chrisl212/ece49022/PCBs/DriveSystem/DriveSystem.kicad_pcb

## KiCad design PCBs/DriveSystem/DriveSystem.kicad_pcb (2019-10-23)

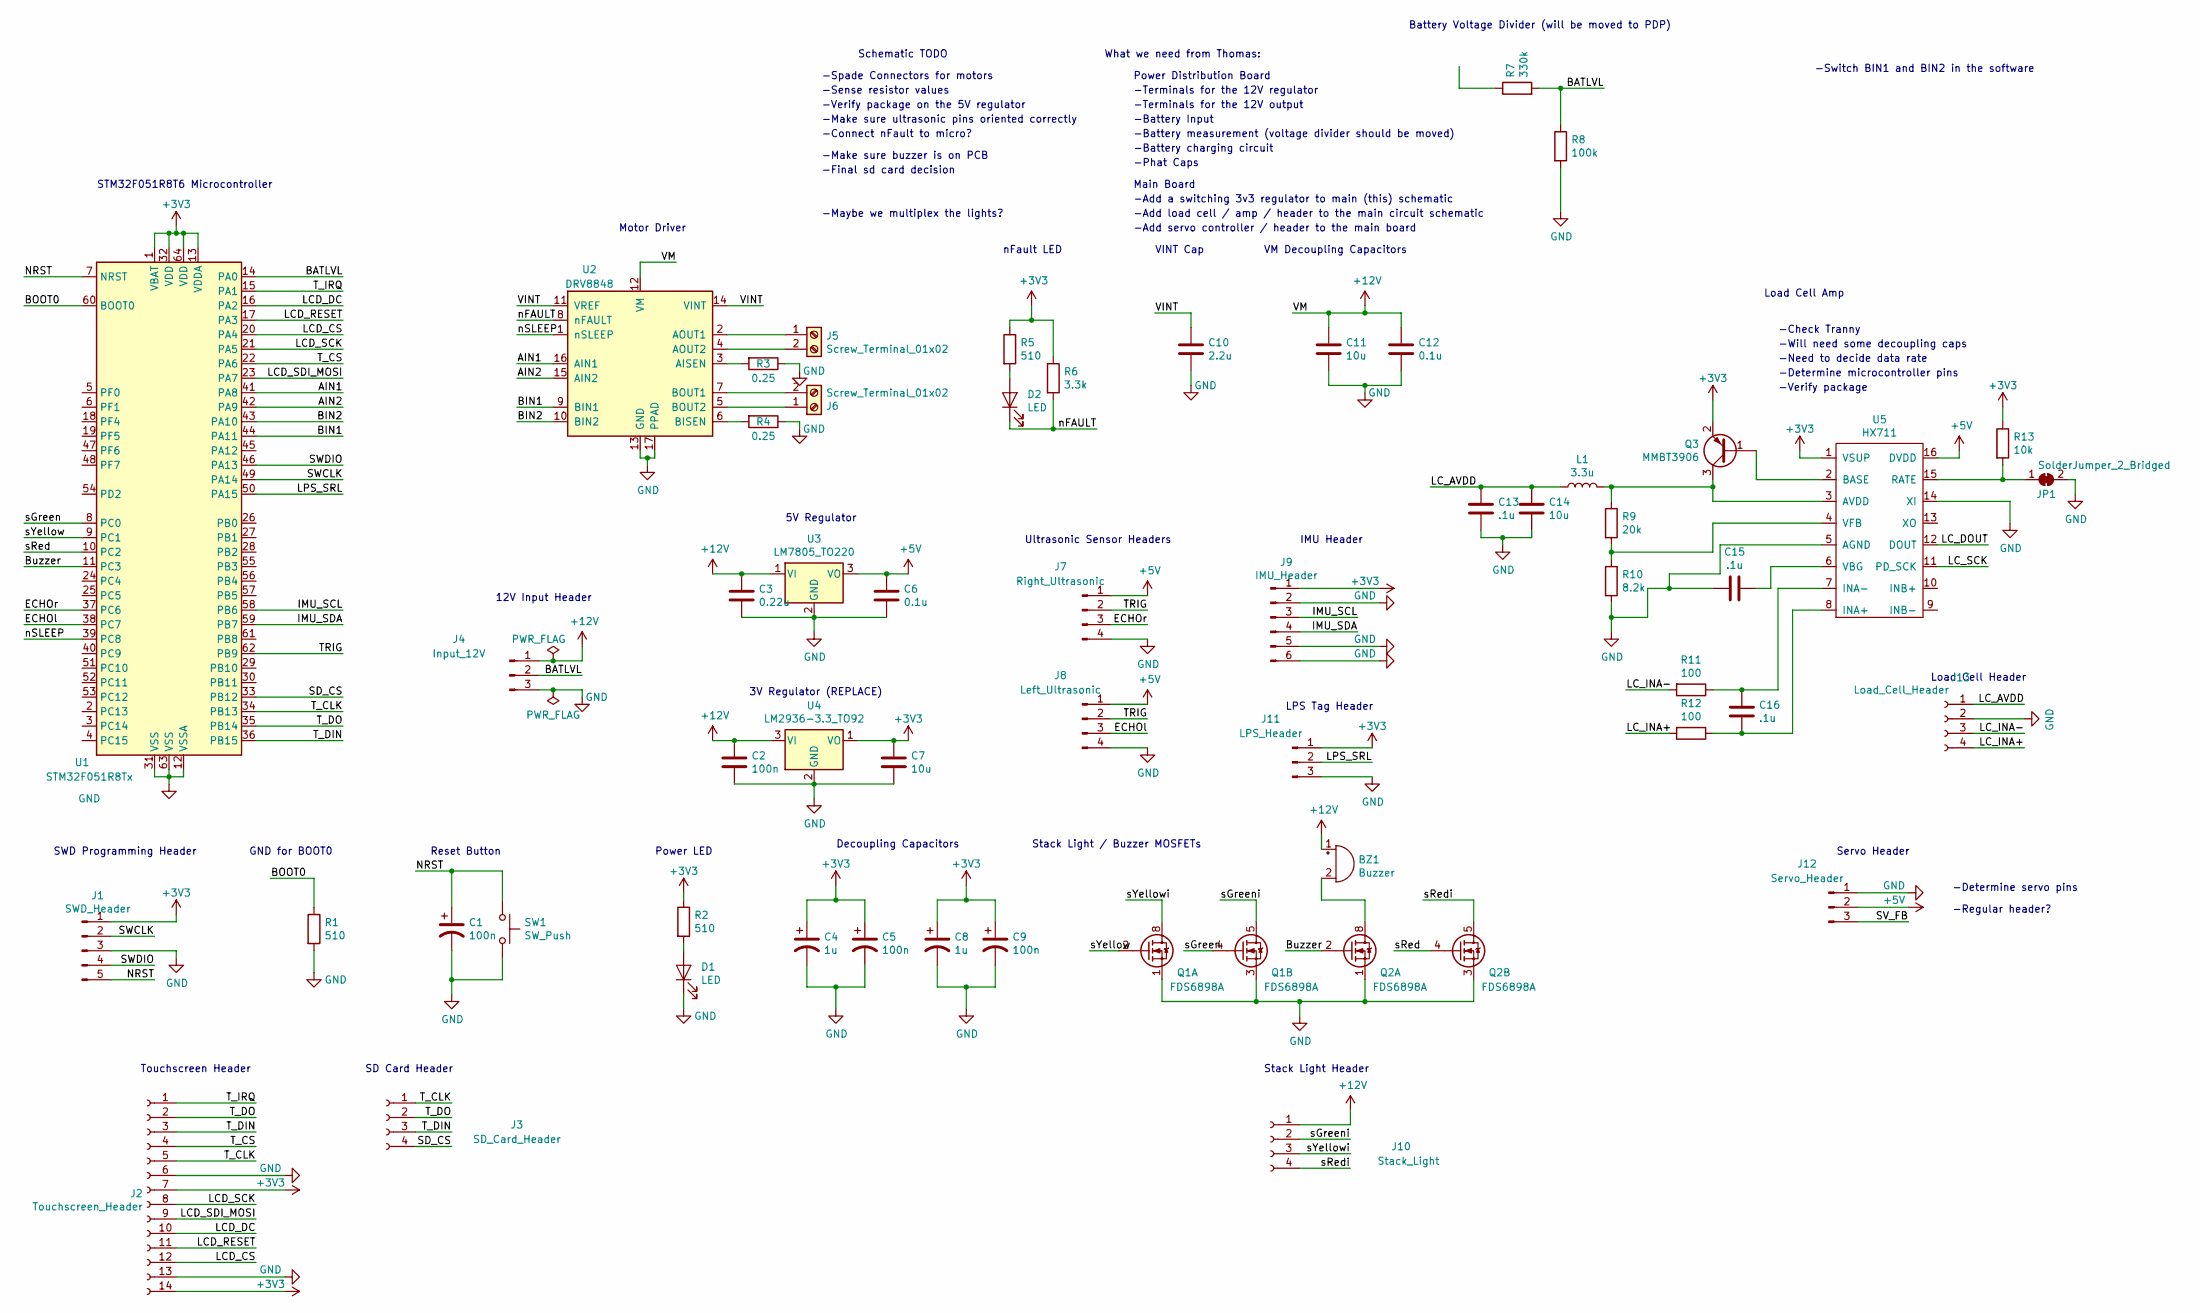
[picture p1: schematic DriveSystem.sch, RoboPicasso Main Board]

Parts:
BZ1: Buzzer; Mallory-PK-27H25PQ-Buzzer
C1, C2, C5, C9: 100n; C_0805_2012Metric_Pad1.15x1.40mm_HandSolder
C3: 0.22u; C_0805_2012Metric_Pad1.15x1.40mm_HandSolder
C4, C8: 1u; C_0805_2012Metric_Pad1.15x1.40mm_HandSolder
C6, C12: 0.1u; C_0805_2012Metric_Pad1.15x1.40mm_HandSolder
C7, C11, C14: 10u; C_0805_2012Metric_Pad1.15x1.40mm_HandSolder
C10: 2.2u; C_0805_2012Metric_Pad1.15x1.40mm_HandSolder
C13, C15, C16: .1u; C_0805_2012Metric_Pad1.15x1.40mm_HandSolder
D1, D2: LED; LED_1206_3216Metric_Pad1.42x1.75mm_HandSolder
J1: SWD_Header; PinHeader_1x05_P2.54mm_Vertical
J2: Touchscreen_Header; PinSocket_1x14_P2.54mm_Vertical
J3: SD_Card_Header; PinSocket_1x04_P2.54mm_Vertical
J4: Input_12V; PinHeader_1x03_P2.54mm_Vertical
J5, J6: Screw_Terminal_01x02; TerminalBlock_4Ucon_1x02_P3.50mm_Horizontal
J7: Right_Ultrasonic; PinHeader_1x04_P2.54mm_Vertical
J8: Left_Ultrasonic; PinHeader_1x04_P2.54mm_Vertical
J9: IMU_Header; PinHeader_1x06_P2.54mm_Vertical
J10: Stack_Light; PinSocket_1x04_P2.54mm_Vertical
J11: LPS_Header; PinHeader_1x03_P2.54mm_Vertical
J12: Servo_Header; PinHeader_1x03_P2.54mm_Vertical
J13: Load_Cell_Header; PinSocket_1x04_P2.54mm_Vertical
JP1: SolderJumper_2_Bridged; SolderJumper-2_P1.3mm_Bridged2Bar_Pad1.0x1.5mm
L1: 3.3u; L_0805_2012Metric_Pad1.15x1.40mm_HandSolder
Q1, Q2: FDS6898A; SOIC-8_3.9x4.9mm_P1.27mm
Q3: MMBT3906; SOT-23
R1, R2, R5: 510; R_0805_2012Metric_Pad1.15x1.40mm_HandSolder
R3, R4: 0.25; R_2512_6332Metric_Pad1.52x3.35mm_HandSolder
R6: 3.3k; R_0805_2012Metric_Pad1.15x1.40mm_HandSolder
R7: 330k; R_0805_2012Metric_Pad1.15x1.40mm_HandSolder
R8: 100k; R_0805_2012Metric_Pad1.15x1.40mm_HandSolder
R9: 20k; R_0805_2012Metric_Pad1.15x1.40mm_HandSolder
R10: 8.2k; R_0805_2012Metric_Pad1.15x1.40mm_HandSolder
R11, R12: 100; R_0805_2012Metric_Pad1.15x1.40mm_HandSolder
R13: 10k; R_0805_2012Metric_Pad1.15x1.40mm_HandSolder
SW1: SW_Push; SW_PUSH_6mm
U1: STM32F051R8Tx; LQFP-64_10x10mm_P0.5mm
U2: DRV8848; TSSOP-16-1EP_4.4x5mm_P0.65mm
U3: LM7805_TO220; TO-220-3_Vertical
U4: LM2936-3.3_TO92; TO-92_Inline
U5: HX711; SOP-16_4.55x10.3mm_P1.27mm

Connections:
+3V3: C4.1, C5.1, C7.1, C8.1, C9.1, J1.1, J2.7, J2.14, J9.1, J11.1, Q3.2 (E), R2.1, R5.1, R6.1, R13.1, U1.1 (VBAT), U1.13 (VDDA), U1.32 (VDD), U1.64 (VDD), U4.1 (VO), U5.1 (VSUP)
+5V: C6.1, J7.1, J8.1, J12.2, U3.3 (VO), U5.16 (DVDD)
+12V: BZ1.1 (-), C2.1, C3.1, C11.1, C12.1, J4.1, J10.1, U2.12 (VM), U3.1 (VI), U4.3 (VI); also elsewhere on the board
/AIN1: U1.41 (PA8), U2.16 (AIN1)
/AIN2: U1.42 (PA9), U2.15 (AIN2)
/BATLVL: J4.2, R7.2, R8.1, U1.14 (PA0)
/BIN1: U1.44 (PA11), U2.9 (BIN1)
/BIN2: U1.43 (PA10), U2.10 (BIN2)
/BOOT0: R1.1, U1.60 (BOOT0)
/Buzz: BZ1.2 (+), Q2.7 (D1), Q2.8 (D1); also elsewhere on the board
/Buzzer: Q2.2 (G1), U1.11 (PC3)
/ECHOl: J8.3, U1.38 (PC7)
/ECHOr: J7.3, U1.37 (PC6)
/IMU_SCL: J9.3, U1.58 (PB6)
/IMU_SDA: J9.4, U1.59 (PB7)
/LCD_CS: J2.12, U1.20 (PA4)
/LCD_DC: J2.10, U1.16 (PA2)
/LCD_RESET: J2.11, U1.17 (PA3)
/LCD_SCK: J2.8, U1.21 (PA5)
/LCD_SDI_MOSI: J2.9, U1.23 (PA7)
/LC_AVDD: C13.2, C14.2, J13.1, L1.1
/LC_DOUT: U5.12 (DOUT)
/LC_INA+: J13.4, R12.2
/LC_INA-: J13.3, R11.2
/LC_SCK: U5.11 (PD_SCK)
/LPS_SRL: J11.2, U1.50 (PA15)
/NRST: C1.1, J1.5, SW1.1, U1.7 (NRST)
/PA12: U1.45 (PA12)
/PB0: U1.26 (PB0); also elsewhere on the board
/PB1: U1.27 (PB1); also elsewhere on the board
/PB2: U1.28 (PB2); also elsewhere on the board
/PB3: U1.55 (PB3)
/PB4: U1.56 (PB4)
/PB5: U1.57 (PB5)
/PB10: U1.29 (PB10); also elsewhere on the board
/PB11: U1.30 (PB11); also elsewhere on the board
/PC4: U1.24 (PC4)
/PC5: U1.25 (PC5)
/PC9: U1.40 (PC9)
/PC10: U1.51 (PC10)
/PC11: U1.52 (PC11)
/PC12: U1.53 (PC12)
/PC13: U1.2 (PC13)
/PC14: U1.3 (PC14)
/PC15: U1.4 (PC15)
/PD2: U1.54 (PD2)
/PF0: U1.5 (PF0)
/PF1: U1.6 (PF1)
/PF4: U1.18 (PF4)
/PF5: U1.19 (PF5)
/PF6: U1.47 (PF6)
/PF7: U1.48 (PF7)
/SD_CS: J3.4, U1.33 (PB12)
/SV_FB: J12.3, U1.61 (PB8)
/SWCLK: J1.2, U1.49 (PA14)
/SWDIO: J1.4, U1.46 (PA13)
/TRIG: J7.2, J8.2, U1.62 (PB9)
/T_CLK: J2.5, J3.1, U1.34 (PB13)
/T_CS: J2.4, U1.22 (PA6)
/T_DIN: J2.3, J3.3, U1.36 (PB15)
/T_DO: J2.2, J3.2, U1.35 (PB14)
/T_IRQ: J2.1, U1.15 (PA1)
/VINT: C10.1, U2.11 (VREF), U2.14 (VINT)
/nFAULT: D2.1 (K), R6.2, U2.8 (nFAULT)
/nSLEEP: U1.39 (PC8), U2.1 (nSLEEP)
/sGreen: Q1.4 (G2), U1.8 (PC0)
/sGreeni: J10.2, Q1.5 (D2), Q1.6 (D2)
/sRed: Q2.4 (G2), U1.10 (PC2)
/sRedi: J10.4, Q2.5 (D2), Q2.6 (D2)
/sYellow: Q1.2 (G1), U1.9 (PC1)
/sYellowi: J10.3, Q1.7 (D1), Q1.8 (D1)
GND: C1.2, C2.2, C3.2, C4.2, C5.2, C6.2, C7.2, C8.2, C9.2, C10.2, C11.2, C12.2, C13.1, C14.1, C15.2, D1.1 (K), J1.3, J2.6, J2.13, J4.3, J7.4, J8.4, J9.2, J9.5, J9.6, J11.3, J12.1, J13.2, JP1.2 (B), Q1.1 (S1), Q1.3 (S2), Q2.1 (S1), Q2.3 (S2), R1.2, R3.1, R4.1, R8.2, R10.2, SW1.2, U1.12 (VSSA), U1.31 (VSS), U1.63 (VSS), U2.13 (GND), U2.17 (PPAD), U3.2 (GND), U4.2 (GND), U5.5 (AGND), U5.14 (XI)
unnamed: C15.1, U5.6 (VBG)
unnamed: C16.1, R12.1, U5.8 (INA+)
unnamed: C16.2, R11.1, U5.7 (INA-)
unnamed: D1.2 (A), R2.2
unnamed: D2.2 (A), R5.2
unnamed: J5.1, U2.2 (AOUT1)
unnamed: J5.2, U2.4 (AOUT2)
unnamed: J6.1, U2.5 (BOUT2)
unnamed: J6.2, U2.7 (BOUT1)
unnamed: JP1.1 (A), R13.2, U5.15 (RATE)
unnamed: L1.2, Q3.3 (C), R9.1, U5.3 (AVDD)
unnamed: Q3.1 (B), U5.2 (BASE)
unnamed: R3.2, U2.3 (AISEN)
unnamed: R4.2, U2.6 (BISEN)
unnamed: R9.2, R10.1, U5.4 (VFB)

Notes on the sheet:
-Spade Connectors for motors
-Sense resistor values
-Verify package on the 5V regulator
-Make sure ultrasonic pins oriented correctly
-Connect nFault to micro?
SWD Programming Header
GND for BOOT0
Reset Button
Power LED
Decoupling Capacitors
5V Regulator
Ultrasonic Sensor Headers
Motor Driver
VINT Cap
nFault LED
VM Decoupling Capacitors
12V Input Header
Schematic TODO
STM32F051R8T6 Microcontroller
Touchscreen Header
SD Card Header
-Make sure buzzer is on PCB
-Final sd card decision
Stack Light / Buzzer MOSFETs
Stack Light Header
What we need from Thomas:
-Terminals for the 12V regulator
-Terminals for the 12V output
-Battery Input
-Battery measurement (voltage divider should be moved)
-Battery charging circuit
-Add load cell / amp / header to the main circuit schematic
-Add a switching 3v3 regulator to main (this) schematic
Power Distribution Board
Main Board
-Add servo controller / header to the main board
-Maybe we multiplex the lights?
Battery Voltage Divider (will be moved to PDP)
-Phat Caps
IMU Header
LPS Tag Header
3V Regulator (REPLACE)
-Check Tranny
-Will need some decoupling caps
-Need to decide data rate
-Determine microcontroller pins
Load Cell Amp
Load Cell Header
Servo Header
-Determine servo pins
-Regular header?
-Verify package
-Switch BIN1 and BIN2 in the software

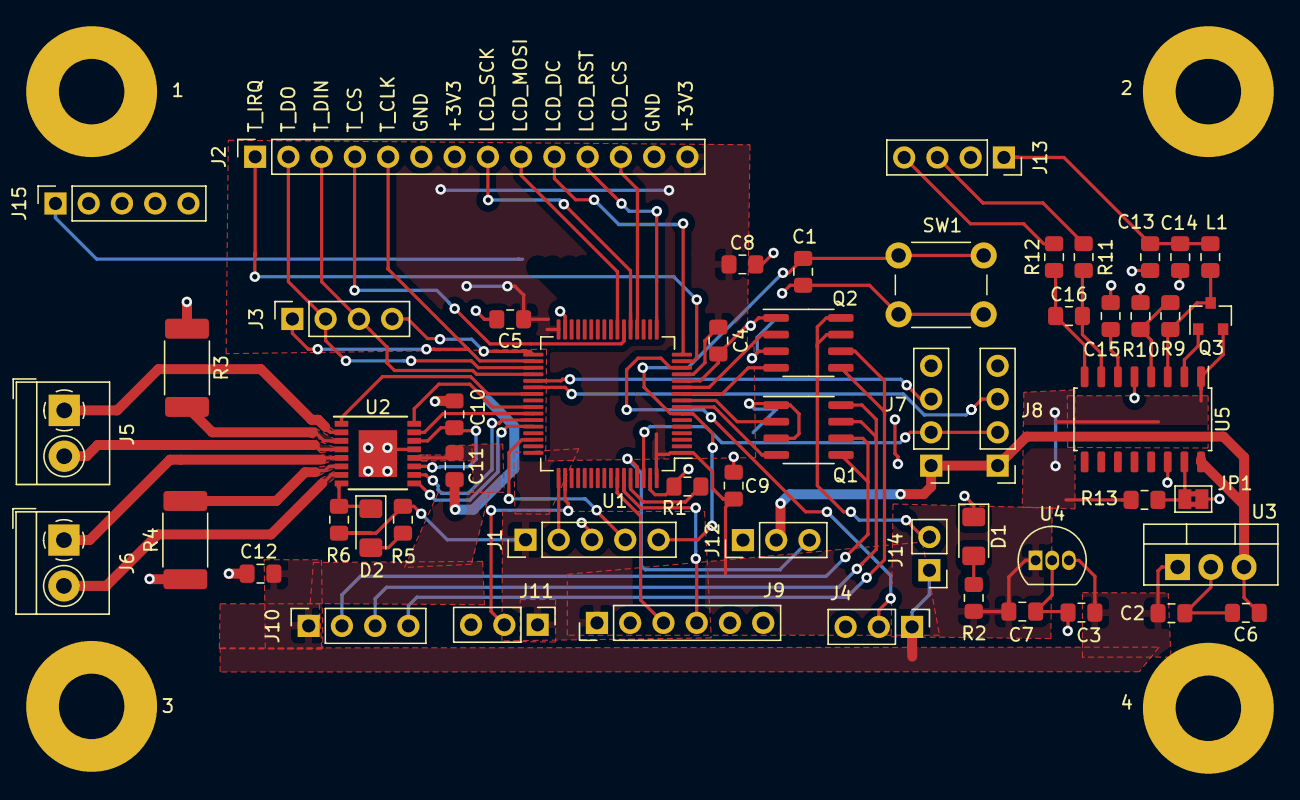
[picture p2: board DriveSystem.kicad_pcb from above]

Board: 2 copper layers, 59 parts (0 on the bottom side), 65 nets.

Other parts of the board:
1, 2, 3, 4: MountingHole_5mm_Pad
J14: Conn_01x02_Male; PinHeader_1x02_P2.54mm_Vertical
J15: Conn_01x05_Female; PinSocket_1x05_P2.54mm_Vertical

Their connections:
+12V: J14.1; also elsewhere on the board
/Buzz: J14.2; also elsewhere on the board
/PB0: J15.5; also elsewhere on the board
/PB1: J15.4; also elsewhere on the board
/PB2: J15.3; also elsewhere on the board
/PB10: J15.2; also elsewhere on the board
/PB11: J15.1; also elsewhere on the board
