chrisl212/ece49022/robo/src/nav/nav.c

#include <stddef.h>
#include "stm32f0xx.h"
#include "ui/text/text.h"
#include "nav.h"
#include "lps/lps.h"
#include "state/state.h"
#include "ui/ui.h"
#include "ui/stack/stack.h"
#include "math/math.h"
#include "drive/drive.h"
#include "sensors/sensors.h"

#define SAMPLES (10)
#define OFFSET (15)
#define TEST (11)

fatFile_t design;
uint16_t initialHead = 0, desiredHead;
int16_t head;
uint16_t desiredX = OFFSET;
uint16_t desiredY = OFFSET;
uint8_t avgCnt;
int lastPoint = 0;

void TIM14_IRQHandler(void) {
    uint8_t p;

    if (load_empty()) {
        state_setErrorMessage("PAINT LOW!!!");
        if (state_get() != STATE_ERR) {
            state_set(STATE_ERR);
            ui_draw();
        }
		GPIOB->ODR |= (1 << TEST);
	    drive_stop();
		drive_move();
		GPIOB->ODR &= ~(1 << TEST);
        return;
    } else if (state_get() == STATE_ERR) {
        state_restore();
        ui_draw();
        drive_start();
    } 
    if (state_get() != STATE_ERR) {
        nav_move(NULL, NULL, &p);
		if (p) {
			servo_on();
		} else {
			servo_off();
		}
        drive_move();
    }
    TIM14->SR &= ~(TIM_SR_UIF);
}

int nav_setup(fatFile_t file) {
    int s;

    design = file;
    lps_setup();

    NVIC_SetPriority(USART2_IRQn, 0);
    NVIC_SetPriority(TIM14_IRQn, 4);
    RCC->APB1ENR |= RCC_APB1ENR_TIM14EN;
    TIM14->PSC = 4800 - 1;
    TIM14->ARR = 10 - 1;
    TIM14->DIER |= TIM_DIER_UIE;
    NVIC->ISER[0] |= 1 << TIM14_IRQn;
    TIM14->CR1 |= TIM_CR1_CEN;

    load_init();
    servo_init();
	while (initialHead == 0)
		lps_getCoords(NULL, NULL, &initialHead);
    return 0;
}

static int _getNextCoords(uint16_t *x, uint16_t *y, uint8_t *p) {
    uint8_t buff[12];
    uint16_t tmpX, tmpY;
    int status;

    status = fat_read(&design, buff, 12);
    tmpX = ((buff[1] << 8) | buff[0]);
    tmpY = 1000 - ((buff[5] << 8) | buff[4]);
    if (p) {
        *p = (buff[9] << 8) | buff[8];
    }
    tmpX /= 10;
    tmpY /= 10;
    *x = tmpX;
    *y = tmpY;
    return status;
}

static int _abs(int x) {
    return (x < 0) ? -x : x;
}

void nav_move(uint16_t *angle, uint8_t *speed, uint8_t *paint) {
    int16_t currentX, currentY;
	uint16_t currentHead;
    uint16_t nextX, nextY;
    int16_t nextHead;
    int status;

    lps_getCoords(&currentX, &currentY, &currentHead);
	head = currentHead - initialHead;
	if (head < 0) {
		head += 360;
	}
    if (_abs(currentX - desiredX) < 20 && _abs(currentY - desiredY) < 20) {
		headPID.integral = 0;
		if (lastPoint) {
			state_set(STATE_DONE);
			ui_draw();
			drive_stop();
			servo_off();
			TIM14->CR1 &= ~(TIM_CR1_CEN);
			return;
		}
		stack_toggle(STACK_RED);
        status = _getNextCoords(&nextX, &nextY, paint);
		desiredX = nextX;
		desiredY = nextY;
    } else {
        nextX = desiredX;
        nextY = desiredY;
    }

    nextHead = atan2(nextY-currentY, nextX-currentX) * 180 / PI;
    if (nextHead < 0) {
        nextHead += 360;
    }
    nextHead = 360 - nextHead;

    if (angle) {
        *angle = nextHead;
    }
    if (speed) {
        *speed = (status != FAT_EOF);
    }

    if (status == FAT_EOF) {
		lastPoint = 1;
    }

    if (state_get() != STATE_ERR) {
        //text_writeFormatAtPoint(f_12x16, 0, 20, LEFT, "(%d, %d) => (%d, %d)          ", currentX, currentY, desiredX, desiredY);
		//text_writeFormatAtPoint(f_12x16, 0, 50, LEFT, "%d deg => %d deg    ", head, nextHead);
	} 

    desiredHead = nextHead;
}
