chrisl212/ece49022/robo/src/fat/sd/sd.h

#ifndef SD_H
#define SD_H

#include <stdint.h>

typedef enum {
    SD_OKAY,
    SD_UNRECOGNIZED,
    SD_UNKNOWN_VERSION,
    SD_TIMEOUT,
    SD_READ_ERR
} sdStatus_t;

typedef enum {
    SD_BYTE,
    SD_BLOCK
} sdAddressingMode_t;

typedef struct {
    sdAddressingMode_t mode;
} sdCard_t;

int sd_init(sdCard_t *card);
int sd_readSector(sdCard_t card, uint32_t addr, uint8_t *buf);
void sd_error(sdStatus_t err);

#endif
