chrisl212/ece49022/(commit log)

2019-09-05 encoder works
2019-10-01 Speed and Heading PID implemented
2019-10-10 Added demo code, made structs work for PID
2019-10-16 added pcb folder
    [DriveSystem.kicad_pcb, DriveSystem.sch]
2019-10-16 added ultrasonic sensors
    [DriveSystem.sch]
2019-10-16 Added circuit descriptions
    [DriveSystem.sch]
2019-10-17 added touchscreen and stack light stuff
    [DriveSystem.sch]
2019-10-18 Added labels and notes
    [DriveSystem.sch]
2019-10-19 Added part footprints
    [DriveSystem.sch]
2019-10-19 added load cell and regulator
2019-10-19 Started pcb tracing
    [DriveSystem.sch]
2019-10-21 First pcb thing done (gotta redo a lot of it)
    [DriveSystem.kicad_pcb, DriveSystem.sch]
2019-10-23 Pcb almost done
    :
    [DriveSystem.kicad_pcb]
2019-10-23 modfied pcb
    [DriveSystem.sch]
